mcox53/SAMD21-Dev-Board/KiCAD/SAMD21-DevBoard.pdf

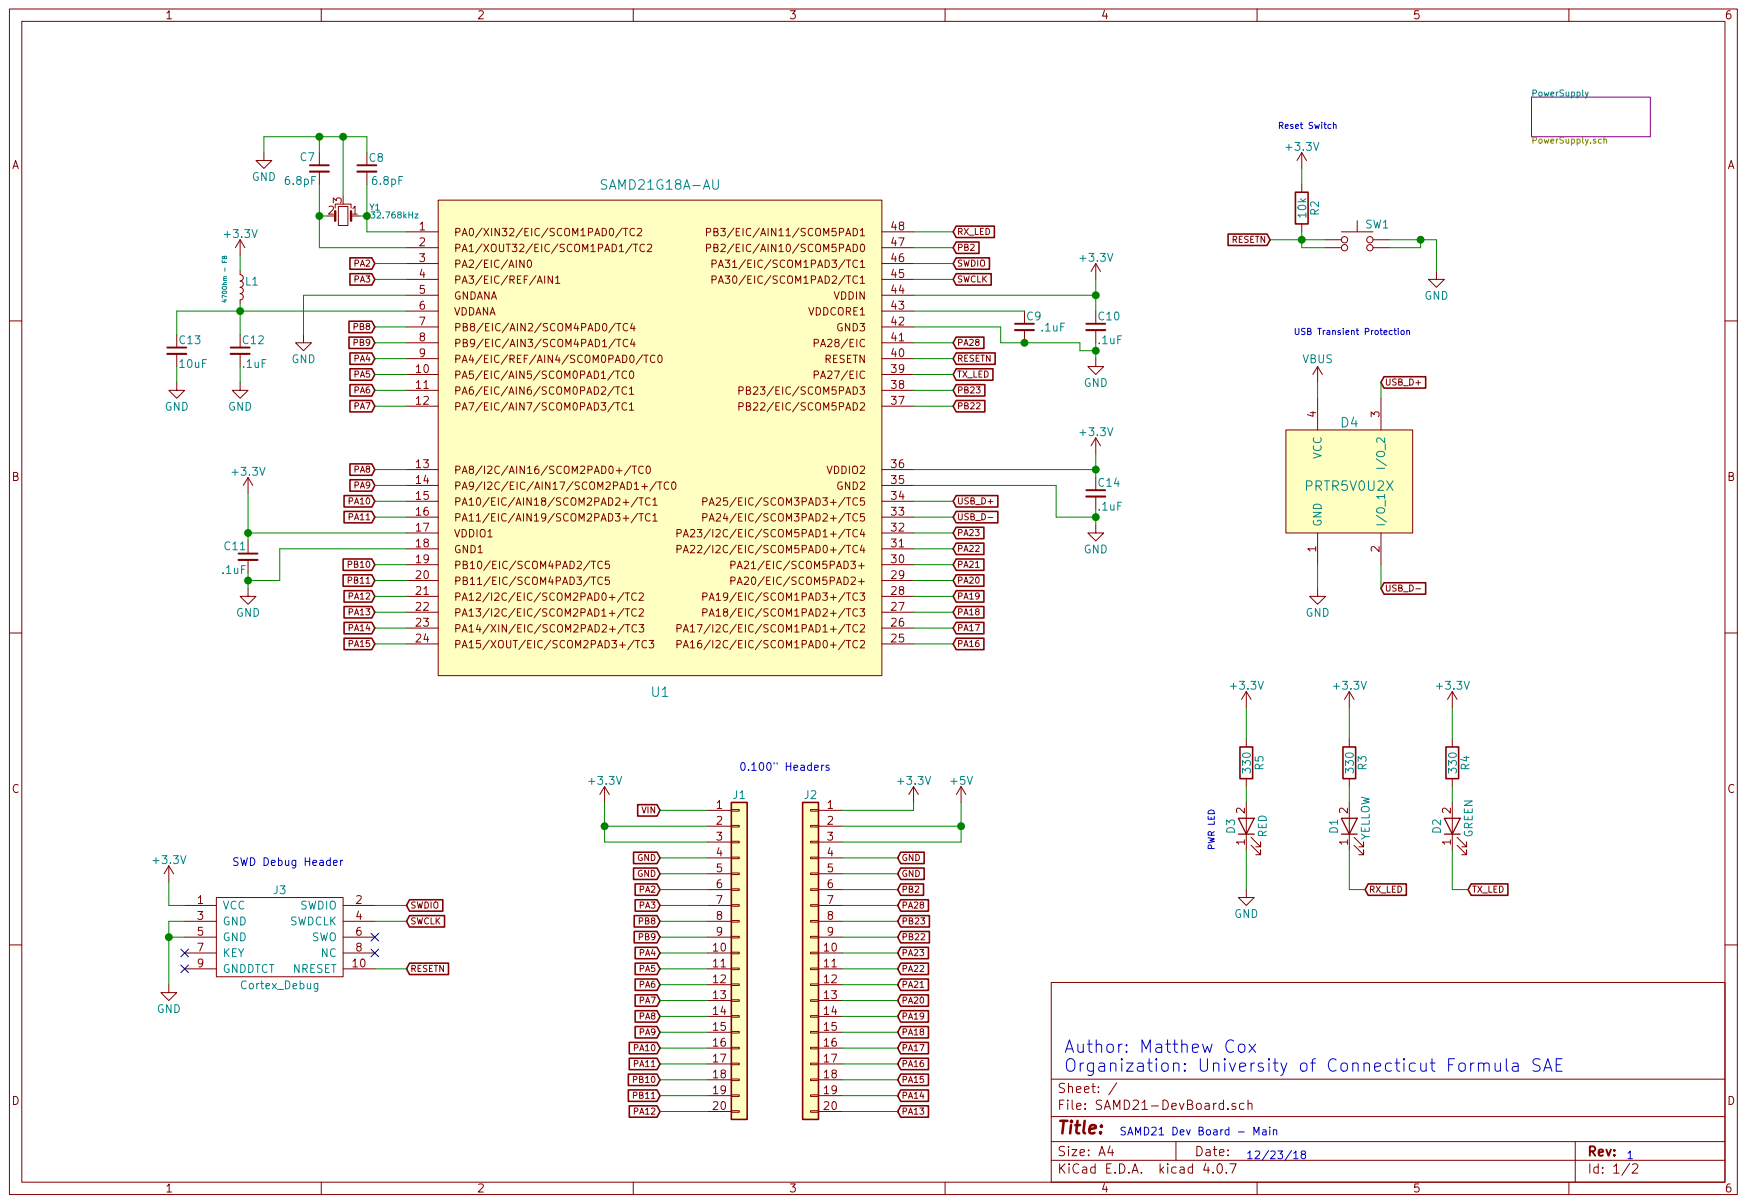
[picture p1: page 1]

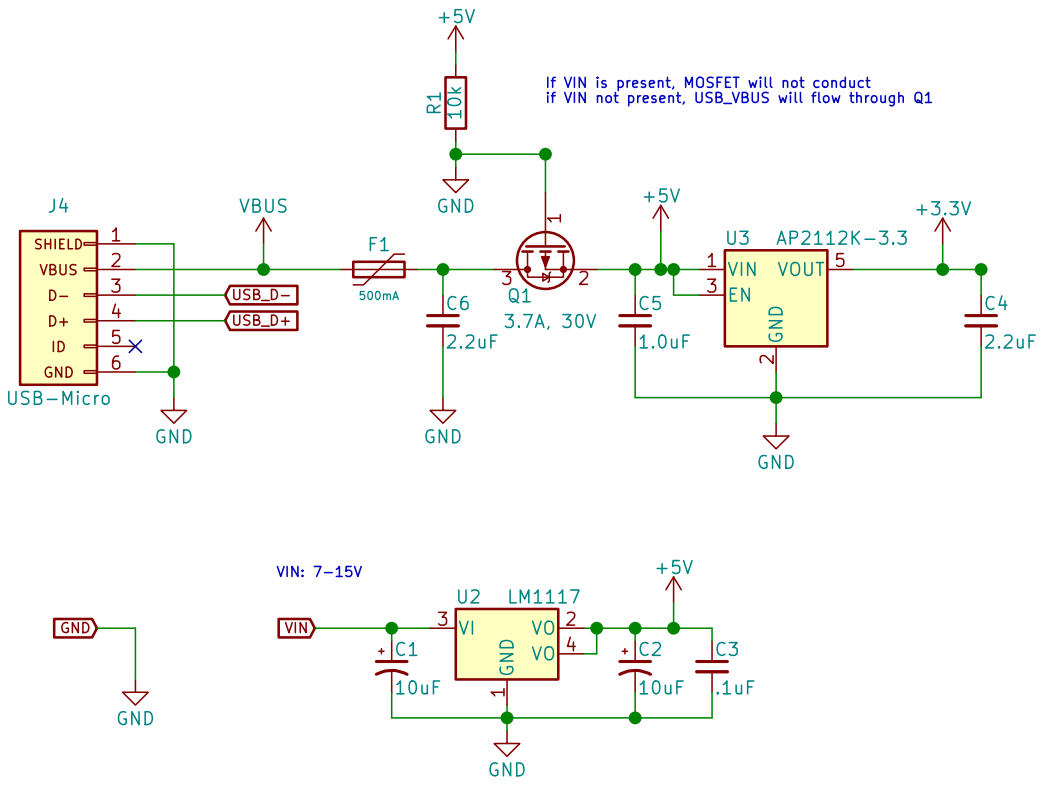
[picture p2: page 2]
