mcox53/SAMD21-Dev-Board/LTSPICE/Power_Switching_Test.asc

C1: cap; 2.2µ
C2: cap; 2.2µ
M1: pmos; IRF7210
R1: res; 10k
R2: res; 0
V1: voltage; 5
V2: voltage; 5
Named nets: 0, +5V, VBUS, VOUT
.tran 3
To test VIN voltage add +5V net label to top of R1. 
This tests the presence of VIN blocking conduction of VBUS.
To test VBUS, remove the +5V net label from top of R1.
R2 is just a test resistor since the source impedance of VBUS and VOUT are not accounted for
To test just VIN operation add +5V net label and remove bus label
