mcox53/SAMD21-Dev-Board/KiCAD/SAMD21-DevBoard.kicad_pcb

## KiCad design KiCAD/SAMD21-DevBoard.kicad_pcb (2019-01-19)

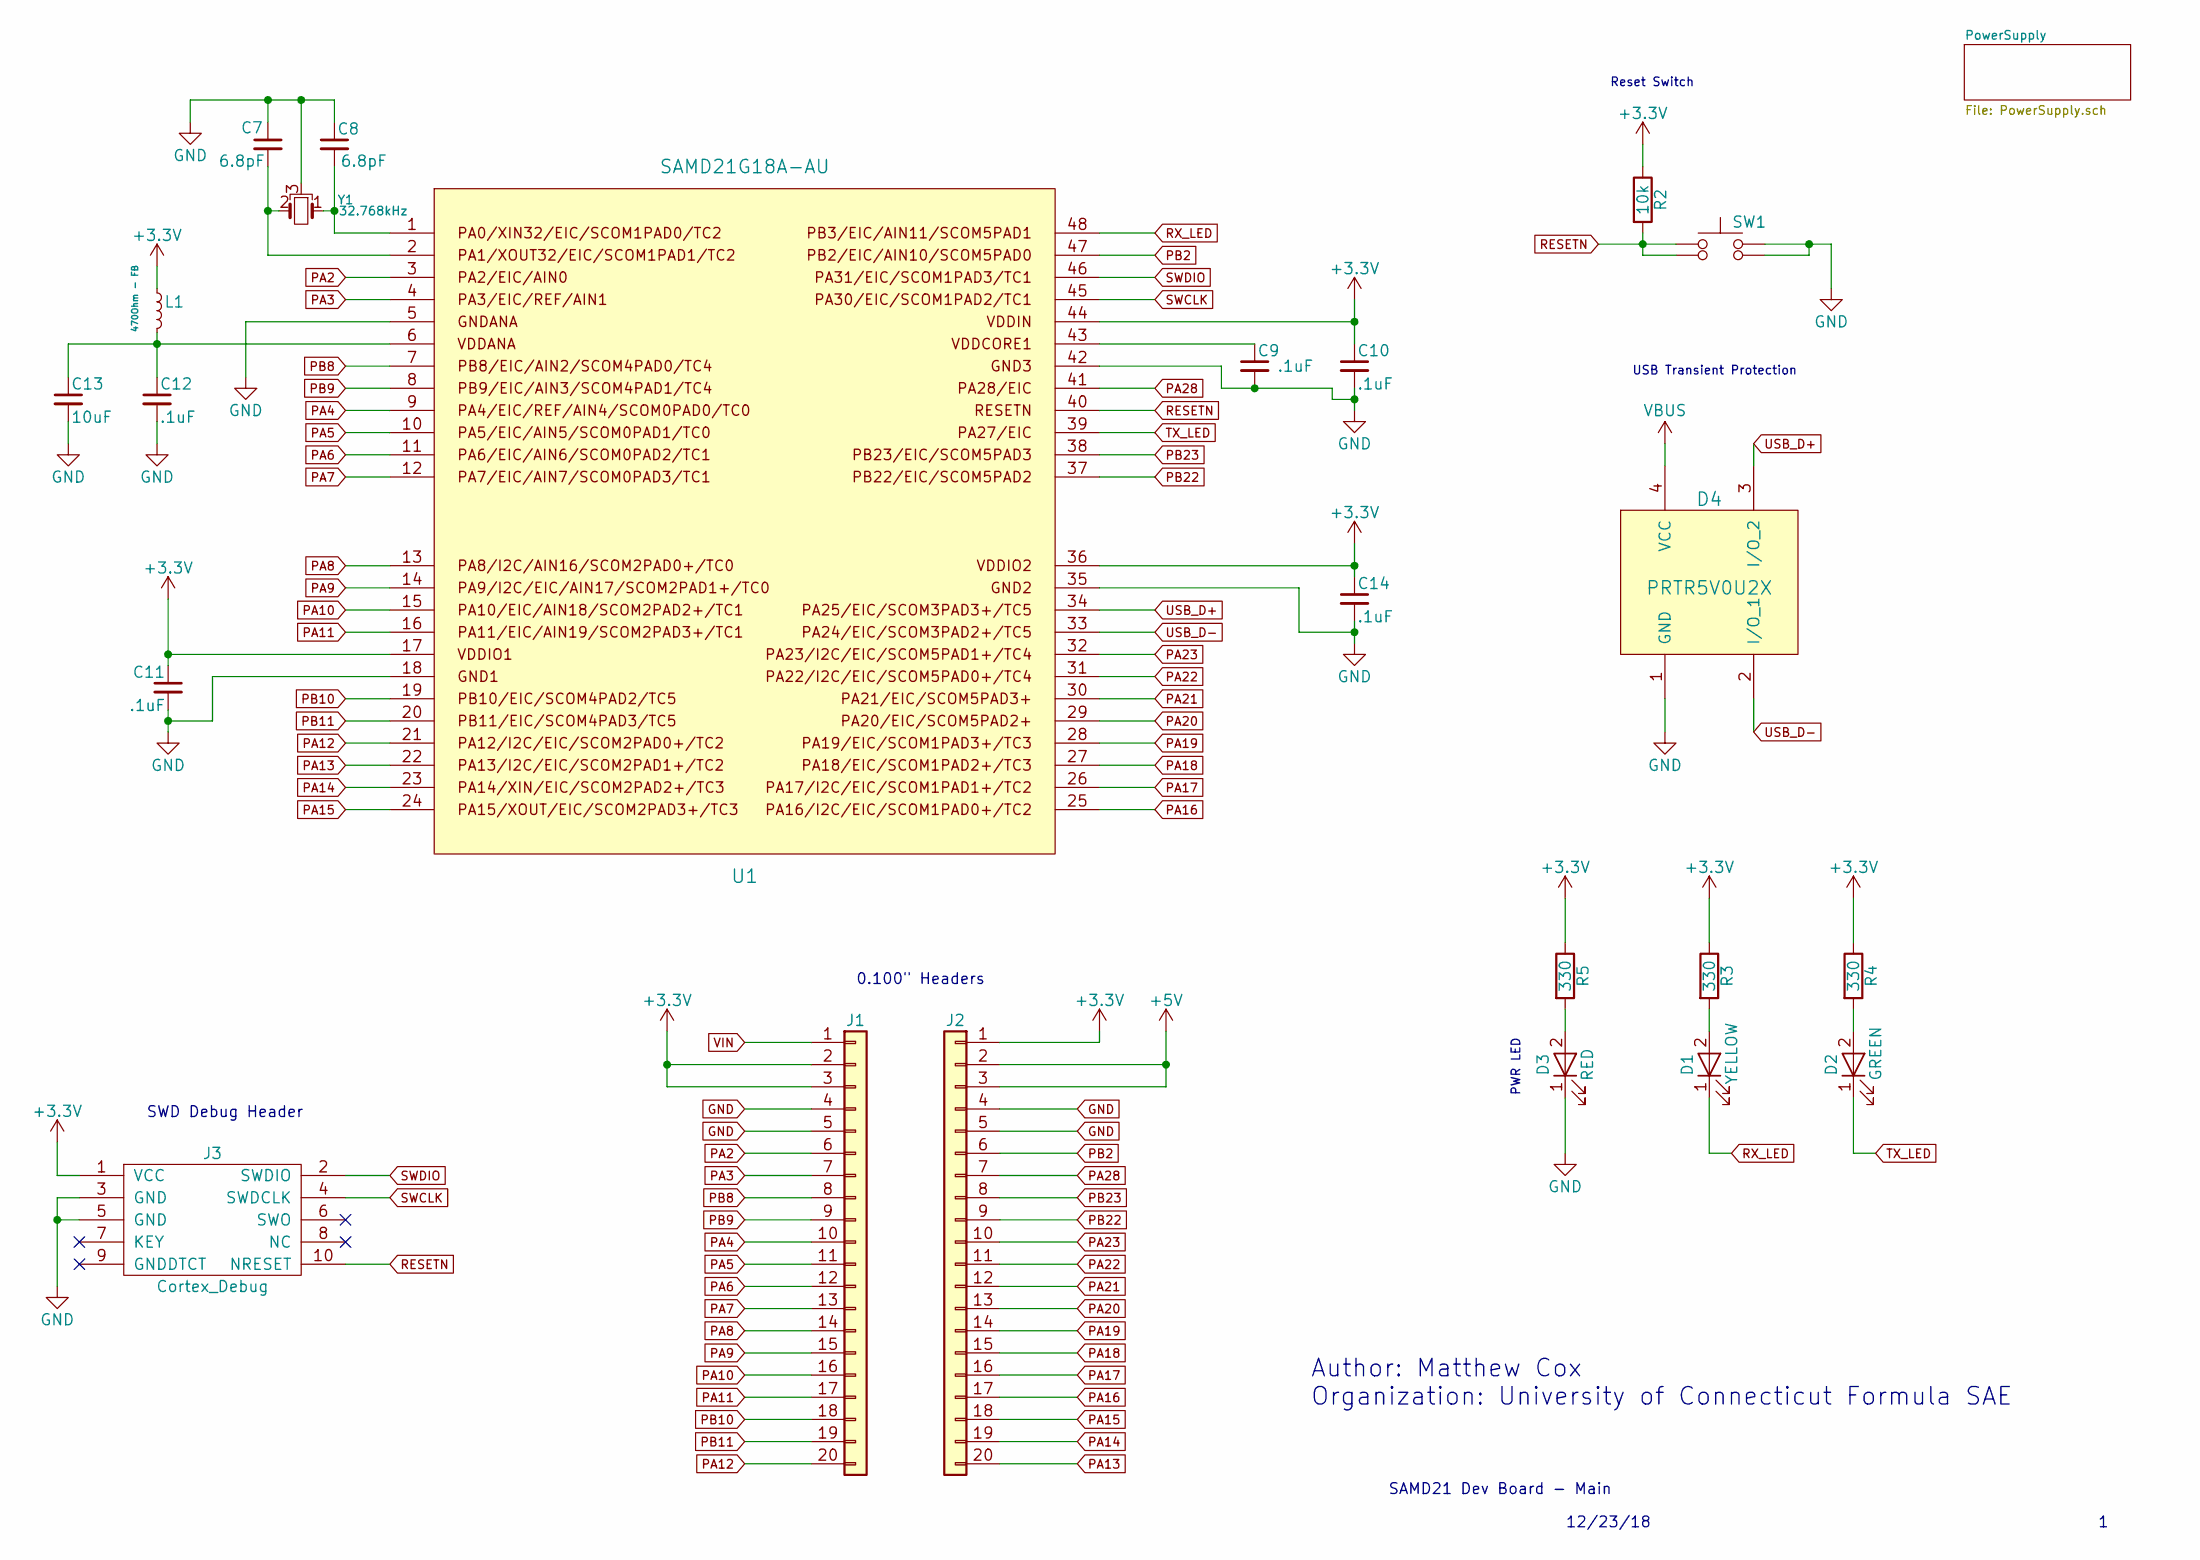
[picture p3: schematic SAMD21-DevBoard.sch]

Parts:
C7, C8: 6.8pF; C_0805
C9, C10, C11, C12, C14: .1uF; C_1206
C13: 10uF; C_1206
D1: YELLOW; LED_1206
D2: GREEN; LED_1206
D3: RED; LED_1206
D4: PRTR5V0U2X; SOT-143
J1, J2: .1\" Headers; Pin_Header_Straight_1x20_Pitch2.54mm
J3: Cortex_Debug; Pin_Header_Straight_2x05_Pitch1.27mm
L1: 470Ohm - FB; L_1806
R2: 10k; R_1210
R3, R4, R5: 330; R_1210
SW1: FSMCTTR
U1: SAMD21G18A-AU; QFP50P900X900X120-48N
Y1: 32.768kHz; MS1V-T1K

Connections:
+3V3: C10.1, C11.1, C14.1, J1.2, J1.3, J2.1, J3.1 (VCC), L1.1, R2.1, R3.1, R4.1, R5.1, U1.17, U1.36, U1.44; also elsewhere on the board
+5V: J2.2, J2.3; also elsewhere on the board
GND: C7.1, C8.1, C9.2, C10.2, C11.2, C12.2, C13.2, C14.2, D3.1 (K), D4.1 (GND), J1.4, J1.5, J2.4, J2.5, J3.3 (GND), J3.5 (GND), SW1.3, SW1.4, U1.5, U1.18, U1.35, U1.42, Y1.3; also elsewhere on the board
unnamed: C7.2, U1.2, Y1.2
unnamed: C8.2, U1.1, Y1.1
unnamed: C9.1, U1.43
unnamed: C12.1, C13.1, L1.2, U1.6
unnamed: D1.2 (A), R3.2
unnamed: D2.2 (A), R4.2
unnamed: D3.2 (A), R5.2
PA2: J1.6, U1.3
PA3: J1.7, U1.4
PA4: J1.10, U1.9
PA5: J1.11, U1.10
PA6: J1.12, U1.11
PA7: J1.13, U1.12
PA8: J1.14, U1.13
PA9: J1.15, U1.14
PA10: J1.16, U1.15
PA11: J1.17, U1.16
PA12: J1.20, U1.21
PA13: J2.20, U1.22
PA14: J2.19, U1.23
PA15: J2.18, U1.24
PA16: J2.17, U1.25
PA17: J2.16, U1.26
PA18: J2.15, U1.27
PA19: J2.14, U1.28
PA20: J2.13, U1.29
PA21: J2.12, U1.30
PA22: J2.11, U1.31
PA23: J2.10, U1.32
PA28: J2.7, U1.41
PB2: J2.6, U1.47
PB8: J1.8, U1.7
PB9: J1.9, U1.8
PB10: J1.18, U1.19
PB11: J1.19, U1.20
PB22: J2.9, U1.37
PB23: J2.8, U1.38
RESETN: J3.10 (NRESET), R2.2, SW1.1, SW1.2, U1.40
RX_LED: D1.1 (K), U1.48
SWCLK: J3.4 (SWDCLK), U1.45
SWDIO: J3.2 (SWDIO), U1.46
TX_LED: D2.1 (K), U1.39
USB_D+: D4.3 (I/O_2), U1.34; also elsewhere on the board
USB_D-: D4.2 (I/O_1), U1.33; also elsewhere on the board
VBUS: D4.4 (VCC); also elsewhere on the board
VIN: J1.1; also elsewhere on the board

Notes on the sheet:
0.100" Headers
SWD Debug Header
PWR LED
Reset Switch
USB Transient Protection
SAMD21 Dev Board - Main
12/23/18
Author: Matthew Cox Organization: University of Connecticut Formula SAE

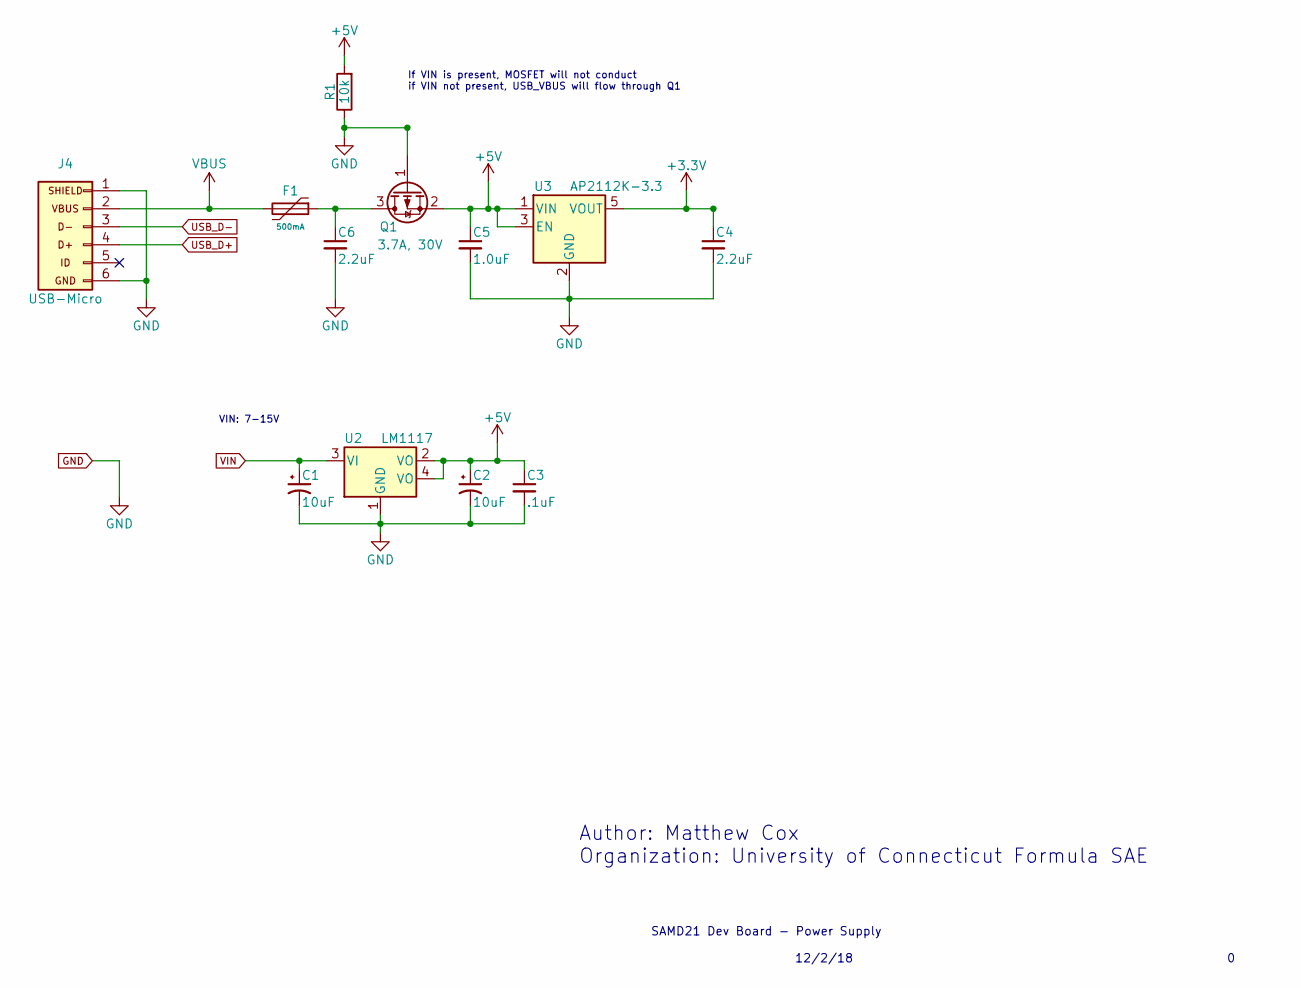
[picture p4: schematic PowerSupply.sch]

Parts:
C1, C2: 10uF; C_1206
C3: .1uF; C_1206
C4, C6: 2.2uF; C_1210
C5: 1.0uF; C_1210
F1: 500mA; R_1210
J4: USB-Micro; 10118192-0001LF
Q1: 3.7A, 30V; SOT-23
R1: 10k; R_1210
U2: LM1117; SOT-223
U3: AP2112K-3.3; SOT-23-5

Connections:
+3V3: C4.1, U3.5 (VOUT); also elsewhere on the board
+5V: C2.1, C3.1, C5.1, Q1.2 (S), R1.2, U2.2 (VO), U2.4 (VO), U3.1 (VIN), U3.3 (EN); also elsewhere on the board
GND: C1.2, C2.2, C3.2, C4.2, C5.2, C6.2, J4.1 (SHIELD), J4.6 (GND), Q1.1 (G), R1.1, U2.1 (GND), U3.2 (GND); also elsewhere on the board
unnamed: C6.1, F1.1, Q1.3 (D)
USB_D+: J4.4 (D+); also elsewhere on the board
USB_D-: J4.3 (D-); also elsewhere on the board
VBUS: F1.2, J4.2 (VBUS); also elsewhere on the board
VIN: C1.1, U2.3 (VI); also elsewhere on the board

Notes on the sheet:
VIN: 7-15V
If VIN is present, MOSFET will not conduct if VIN not present, USB_VBUS will flow through Q1
SAMD21 Dev Board - Power Supply
12/2/18
Author: Matthew Cox Organization: University of Connecticut Formula SAE

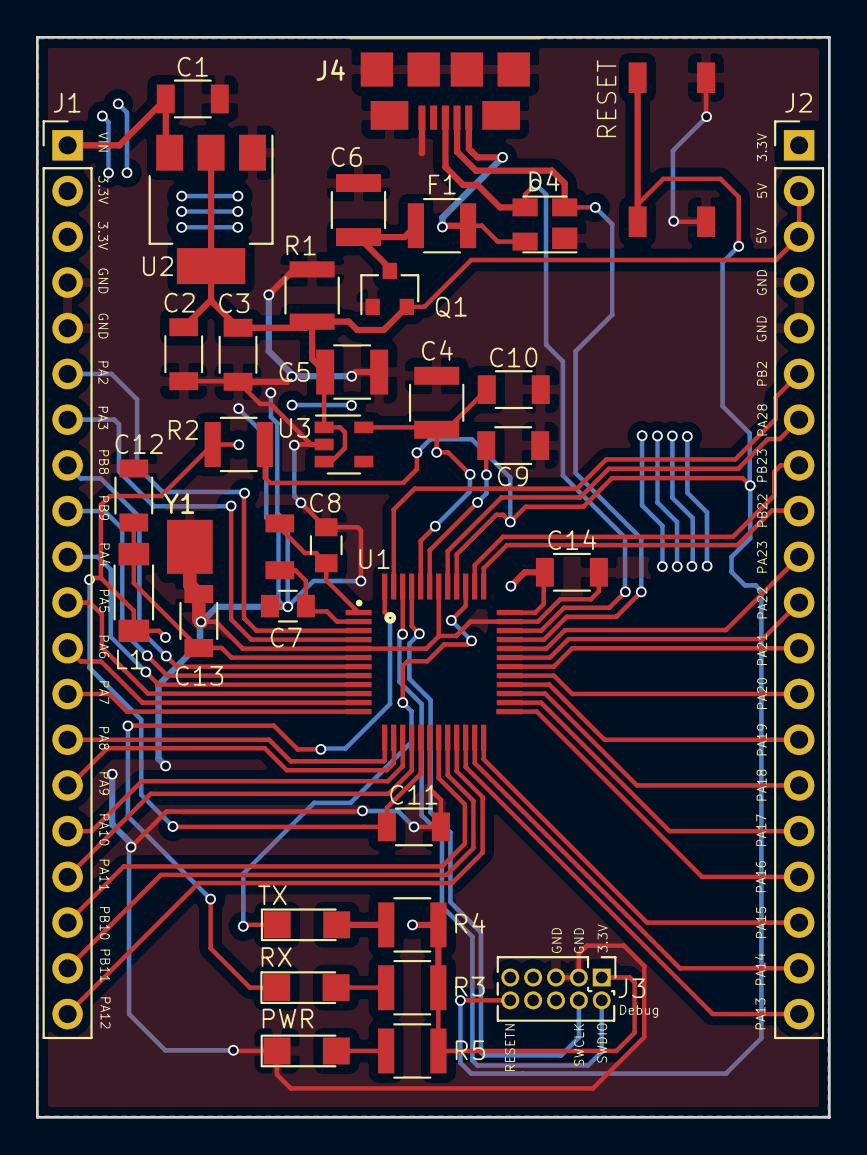
[picture p5: board SAMD21-DevBoard.kicad_pcb from above]

Board: 2 copper layers, 44.0 x 60.0 mm, 35 parts (0 on the bottom side), 50 nets.
