mcox53/SAMD21-Dev-Board/(commit log)

2018-11-19 Imported libraries from Dashboard PCB for usage
2018-11-19 Created Schematic Symbols for fuse, USB Connector, 5V and 3.3V regulator
2018-11-19 Made it through most of power supply schematic
    [PowerSupply.sch, SAMD21-DevBoard.kicad_pcb, SAMD21-DevBoard.sch]
2018-11-19 Made Cortex Debug Schematic Symbol
    [_saved_SAMD21-DevBoard.sch]
2018-11-19 Broke out pins from MCU and added data bus protection diode
    [PowerSupply.sch, SAMD21-DevBoard.sch]
2018-12-01 Created library for 4 pin SPST switch
2018-12-01 Editing capacitor values, prepping for layout phase
    [PowerSupply.sch, SAMD21-DevBoard.sch, _saved_SAMD21-DevBoard.sch]
2018-12-02 Add TX & RX LEDs, tweak values
    [SAMD21-DevBoard.sch]
2018-12-02 Import SAMD21G18A-AU Footprint
2018-12-02 Schematic Rev 0
    [_saved_PowerSupply.sch, _saved_SAMD21-DevBoard.sch]
2018-12-02 Created footprints for switch, micro usb port and crystal
    [PowerSupply.sch, SAMD21-DevBoard.sch, _saved_PowerSupply.sch, _saved_SAMD21-DevBoard.sch]
2018-12-06 Generate netlist and begin layout
    [PowerSupply.sch, SAMD21-DevBoard.sch]
2018-12-08 Board layout and fixing schematic errors
    [PowerSupply.sch, SAMD21-DevBoard.kicad_pcb, SAMD21-DevBoard.sch, _saved_SAMD21-DevBoard.sch]
2018-12-08 Custom LM1117 Library
    Created a LM1117 library that has the tab (Pin 4) connected to the voltage output.
2018-12-09 Place and route
    [PowerSupply.sch, SAMD21-DevBoard.kicad_pcb, SAMD21-DevBoard.sch, _saved_SAMD21-DevBoard.sch]
2018-12-21 Created schematic symbol and footprint for new tactile switch
2018-12-21 Revising layout with different board outline
    [PowerSupply.sch, SAMD21-DevBoard.kicad_pcb, SAMD21-DevBoard.sch]
2018-12-23 Fixed pad numbers in footprint to match connector
2018-12-23 More routing
    [SAMD21-DevBoard.kicad_pcb]
2018-12-23 Finished routing, now fine tweaking and tuning
    [PowerSupply.sch, SAMD21-DevBoard.kicad_pcb]
2018-12-24 Attempting to increase top flood plane connectivity
    [SAMD21-DevBoard.kicad_pcb]
2018-12-24 Fix library error
    [PowerSupply.sch, SAMD21-DevBoard.sch]
2018-12-24 Schematic Rev 1
2018-12-24 Simulations verifying mosfet switching circuit
2019-01-19 Fixed pad spacing on USB connector
2019-01-19 Added GND connection to pad 3
2019-01-19 Revised crystal symbol and updated layout slightly
    [SAMD21-DevBoard.kicad_pcb, SAMD21-DevBoard.sch]
2019-01-19 Schematic Rev 2 (Production 1)
2019-01-19 PCB Rev 0 (Production 1)
    [SAMD21-DevBoard-B.Cu.gbr, SAMD21-DevBoard-B.Mask.gbr, SAMD21-DevBoard-B.SilkS.gbr, SAMD21-DevBoard-Edge.Cuts.gbr, SAMD21-DevBoard-F.Cu.gbr, SAMD21-DevBoard-F.Mask.gbr, SAMD21-DevBoard-F.SilkS.gbr, SAMD21-DevBoard.drl]
2019-02-03 Updated temporary copy of dev board firmware. See README for more
